chithigun23/ANUFS-GearPositionSTM/gearPosSens.kicad_pcb

## KiCad design gearPosSens.kicad_pcb (2026-11-10)

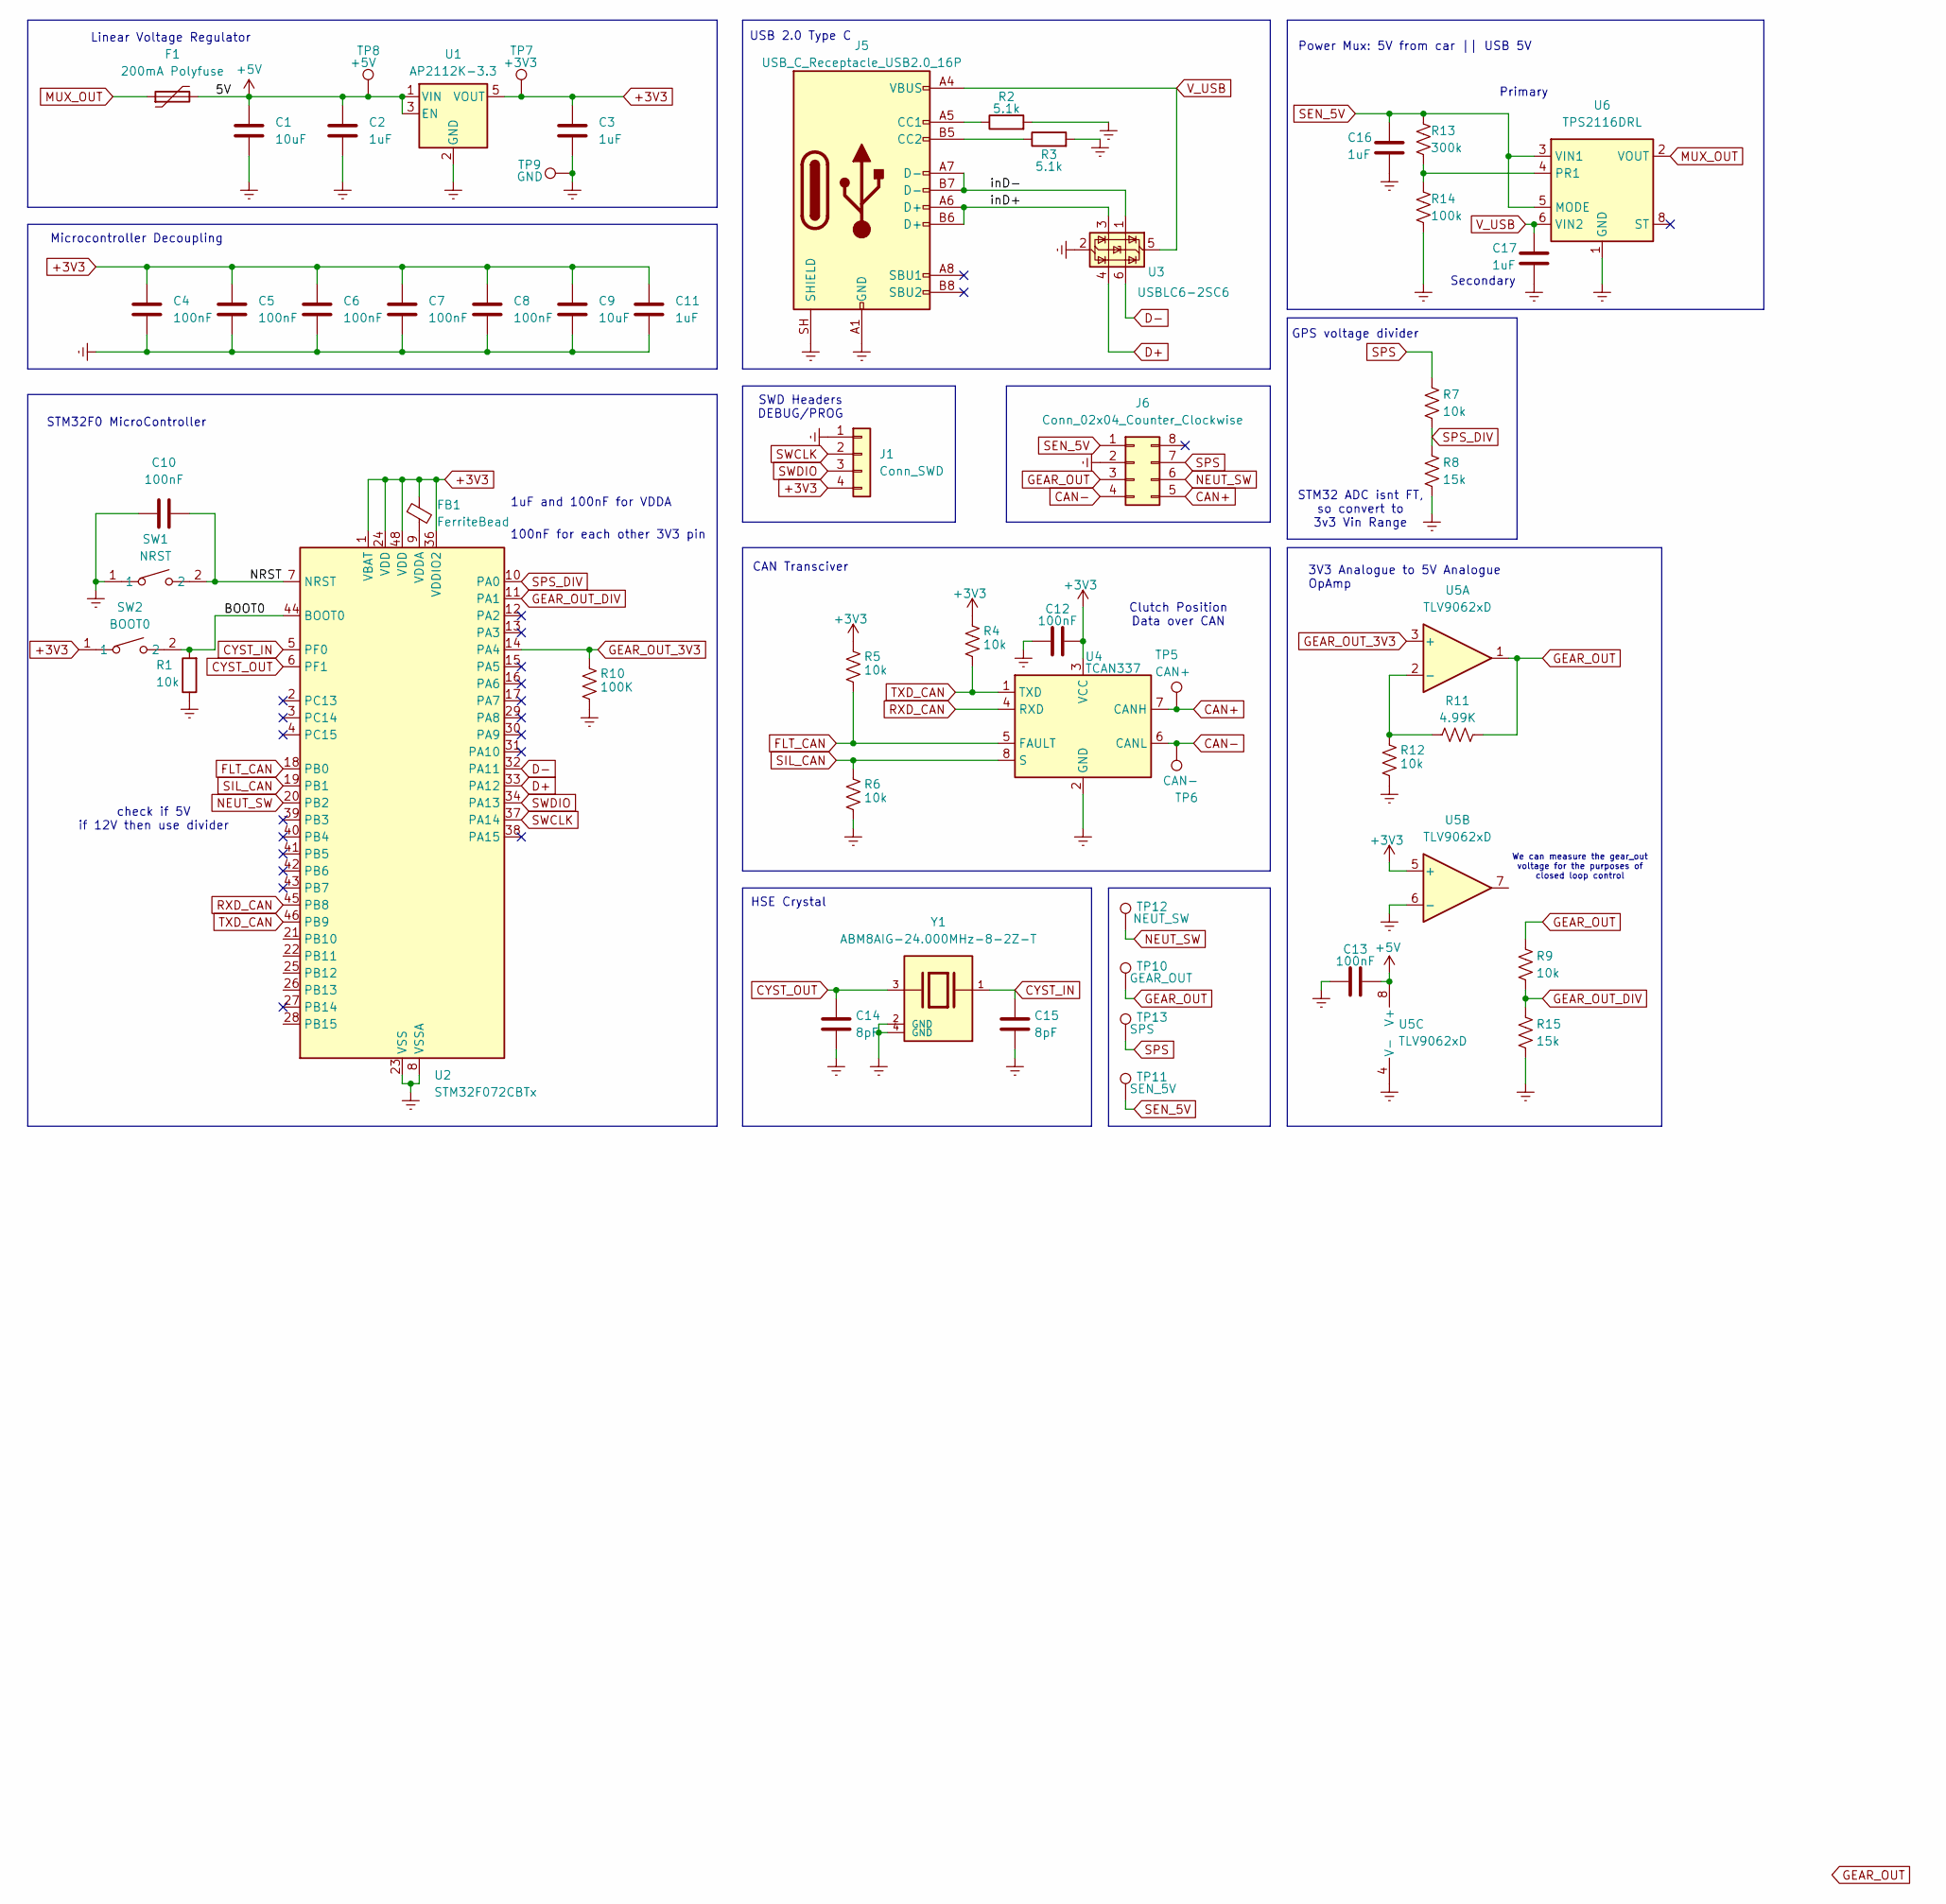
[picture p1: schematic gearPosSens.kicad_sch]

Parts:
C1, C9: 10uF; R_0805_2012Metric_Pad1.20x1.40mm_HandSolder
C2, C3, C11, C16, C17: 1uF; R_0805_2012Metric_Pad1.20x1.40mm_HandSolder
C4, C5, C6, C7, C8, C10, C12, C13: 100nF; R_0805_2012Metric_Pad1.20x1.40mm_HandSolder
C14, C15: 8pF; C_0402_1005Metric_Pad0.74x0.62mm_HandSolder
F1: 200mA Polyfuse; C_0603_1608Metric_Pad1.08x0.95mm_HandSolder
FB1: FerriteBead; C_0603_1608Metric_Pad1.08x0.95mm_HandSolder
J1: Conn_SWD; PinHeader_1x04_P2.54mm_Vertical
J5: USB_C_Receptacle_USB2.0_16P; USB-C-SMD_TYPE-C-16PIN-2MD-073
J6: Conn_02x04_Counter_Clockwise
R1, R4, R5, R6, R7, R9, R12: 10k; R_0805_2012Metric_Pad1.20x1.40mm_HandSolder
R2, R3: 5.1k; R_0805_2012Metric_Pad1.20x1.40mm_HandSolder
R8, R15: 15k; R_0805_2012Metric_Pad1.20x1.40mm_HandSolder
R10: 100K; R_0805_2012Metric_Pad1.20x1.40mm_HandSolder
R11: 4.99K
R13: 300k; R_0805_2012Metric_Pad1.20x1.40mm_HandSolder
R14: 100k; R_0805_2012Metric_Pad1.20x1.40mm_HandSolder
SW1: NRST; SW-SMD_L3.9-W3.0-P4.45; MPN TS-1088-AR02016; LCSC Part C720477
SW2: BOOT0; SW-SMD_L3.9-W3.0-P4.45; MPN TS-1088-AR02016; LCSC Part C720477
TP5: CAN+; TestPoint_THTPad_D2.0mm_Drill1.0mm
TP6: CAN-; TestPoint_THTPad_D2.0mm_Drill1.0mm
TP7: +3V3; TestPoint_THTPad_D2.0mm_Drill1.0mm
TP8: +5V; TestPoint_THTPad_D2.0mm_Drill1.0mm
TP9: GND; TestPoint_THTPad_D2.0mm_Drill1.0mm
TP10: GEAR_OUT; TestPoint_THTPad_D2.0mm_Drill1.0mm
TP11: SEN_5V; TestPoint_THTPad_D2.0mm_Drill1.0mm
TP12: NEUT_SW; TestPoint_THTPad_D2.0mm_Drill1.0mm
TP13: SPS; TestPoint_THTPad_D2.0mm_Drill1.0mm
U1: AP2112K-3.3; SOT-23-5_HandSoldering
U2: STM32F072CBTx; LQFP-48_7x7mm_P0.5mm
U3: USBLC6-2SC6; SOT-23-6
U4: TCAN337; SOIC-8_3.9x4.9mm_P1.27mm
U5: TLV9062xD; SOIC-8_3.9x4.9mm_P1.27mm
U6: TPS2116DRL; SOT-583-8
Y1: ABM8AIG-24.000MHz-8-2Z-T; ABM8AIG-24.000MHZ-8-2Z-T; PARTREV 43629

Connections:
+3V3: C3.1, C4.2, C5.2, C6.2, C7.2, C8.2, C9.2, C11.1, C12.2, FB1.1, J1.4, R4.1, R5.1, SW2.1, TP7.1 (1_1), U1.5 (VOUT), U2.1 (VBAT), U2.24 (VDD), U2.36 (VDDIO2), U2.48 (VDD), U4.3 (VCC), U5.5 (+); also elsewhere on the board
/BOOT0: R1.2, SW2.2, U2.44 (BOOT0)
/NRST: C10.2, SW1.2, U2.7 (NRST)
/inD+: J5.A6 (D+), J5.B6 (D+), U3.3 (I/O2)
/inD-: J5.A7 (D-), J5.B7 (D-), U3.1 (I/O1)
CAN+: J6.5, TP5.1 (1_1), U4.7 (CANH); also elsewhere on the board
CAN-: J6.4, TP6.1 (1_1), U4.6 (CANL); also elsewhere on the board
CYST_IN: C15.1, U2.5 (PF0), Y1.1
CYST_OUT: C14.1, U2.6 (PF1), Y1.3
D+: U2.33 (PA12), U3.4 (I/O2)
D-: U2.32 (PA11), U3.6 (I/O1)
FLT_CAN: R5.2, U2.18 (PB0), U4.5 (FAULT)
GEAR_OUT: J6.3, R9.1, R11.2, TP10.1 (1_1), U5.1
GEAR_OUT_3V3: R10.1, U2.14 (PA4), U5.3 (+)
GEAR_OUT_DIV: R9.2, R15.1, U2.11 (PA1)
GND: C1.1, C2.2, C3.2, C4.1, C5.1, C6.1, C7.1, C8.1, C9.1, C10.1, C11.2, C12.1, C13.1, C14.2, C15.2, C16.1, C17.1, J1.1, J5.A1 (GND), J5.A12 (GND), J5.B1 (GND), J5.B12 (GND), J5.SH (SHIELD), J6.2, R1.1, R2.2, R3.2, R6.2, R8.2, R10.2, R12.2, R14.2, R15.2, SW1.1, TP9.1 (1_1), U1.2 (GND), U2.8 (VSSA), U2.23 (VSS), U2.35 (VSS), U2.47 (VSS), U3.2 (GND), U4.2 (GND), U5.4 (V-), U5.6 (-), U6.1 (GND), Y1.2 (GND), Y1.4 (GND)
NEUT_SW: J6.6, TP12.1 (1_1), U2.20 (PB2)
unnamed: J5.A5 (CC1), R2.1
unnamed: J5.B5 (CC2), R3.1
unnamed: FB1.2, U2.9 (VDDA)
unnamed: R11.1, R12.1, U5.2 (-)
unnamed: R13.2, R14.1, U6.4 (PR1)
RXD_CAN: U2.45 (PB8), U4.4 (RXD)
SEN_5V: C16.2, J6.1, R13.1, TP11.1 (1_1), U6.3 (VIN1), U6.5 (MODE)
SIL_CAN: R6.1, U2.19 (PB1), U4.8 (S)
SPS: J6.7, R7.1, TP13.1 (1_1)
SPS_DIV: R7.2, R8.1, U2.10 (PA0)
SWCLK: J1.2, U2.37 (PA14)
SWDIO: J1.3, U2.34 (PA13)
TXD_CAN: R4.2, U2.46 (PB9), U4.1 (TXD)
V_USB: C17.2, J5.A4 (VBUS), J5.A9 (VBUS), J5.B4 (VBUS), J5.B9 (VBUS), U3.5 (VBUS), U6.6 (VIN2)

Notes on the sheet:
We can measure the gear_out voltage for the purposes of closed loop control
GPS voltage divider
100nF for each other 3V3 pin
Microcontroller Decoupling
3V3 Analogue to 5V Analogue OpAmp
CAN Transciver
Secondary
SWD Headers DEBUG/PROG
Power Mux: 5V from car || USB 5V
HSE Crystal
1uF and 100nF for VDDA
Clutch Position Data over CAN
USB 2.0 Type C
Linear Voltage Regulator
check if 5V if 12V then use divider
Primary
STM32F0 MicroController
STM32 ADC isnt FT, so convert to 3v3 Vin Range

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
Board: 4 copper layers, 56 parts (0 on the bottom side), 33 nets, no tracks yet.

Other parts of the board:
TP14: +3V3; TestPoint_THTPad_D2.0mm_Drill1.0mm
TP15: CAN+; TestPoint_THTPad_D2.0mm_Drill1.0mm
TP16: CAN-; TestPoint_THTPad_D2.0mm_Drill1.0mm

Their connections:
+3V3: TP14.1 (1_1); also elsewhere on the board
CAN+: TP15.1 (1_1); also elsewhere on the board
CAN-: TP16.1 (1_1); also elsewhere on the board
