chithigun23/ANUFS-GearPositionSTM/(commit log)

2026-09-03 Added DAC
    [gearPosSens.kicad_pcb, gearPosSens.kicad_sch]
2026-09-03 Finished circuit design draft
    [gearPosSens.kicad_pcb, gearPosSens.kicad_sch]
2026-09-03 change in file structure
    [gearPosSens.kicad_pcb, gearPosSens.kicad_sch]
2026-09-03 Added more test points
    [gearPosSens.kicad_sch]
2026-09-08 Checkpoint before power-mux schematic placement
    Adds the gear library parts for the car-12V/USB-5V power mux
    (SMBJ33A, PMEG6010ER, LMR33630ADDAR, TPS2113APWR) plus session notes,
    captured as a clean baseline before the mux is wired into the schematic
    so that change can be reverted independently if needed.
    [gearPosSens.kicad_pcb]
2026-09-08 Add car-12V/USB-5V power mux to the schematic
    Adds a self-contained block (own bounding rectangle, upper right, on a
    newly-widened A3 sheet) implementing the mux discussed: WAGO 12V input
    (J6) -> SMBJ33A TVS + 500mA polyfuse (F2) + PMEG6010ER reverse-polarity
    diode (D1) -> LMR33630ADDAR buck to 5V (U6) -> TPS2113APWR ideal-diode
    mux (U7, autoswitching: VSNS/EN/GND grounded) -> VIN_LDO.
    The only edit to existing content: the single wire segment directly
    between F1 and the rest of the VIN_LDO run is cut, F1's pin is relabeled
    5V_USB (feeding the mux's IN2), and the untouched VIN_LDO label/run now
    picks up power from the mux's OUT pin instead of straight from F1 -- so
    U1 and everything else al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
    [gearPosSens.kicad_sch]
2026-09-11 Removed buck converter as 12V is not required
    [gearPosSens.kicad_pcb, gearPosSens.kicad_sch]
2026-09-11 Added crystal for HSE, required for CAN
    [gearPosSens.kicad_sch]
2026-09-11 Move HSE crystal into the gear library
    Y1 pointed at the apppd footprint and telemetry symbol libraries, neither of which this project declares, so the footprint could not be placed on the PCB. The ABM8AIG-24.000MHz-8-2Z-T symbol, footprint and 3D model now live in library/ and Y1 uses the gear nickname. The symbol library table also had an empty type, which stopped KiCad loading the gear library at all; it is now KiCad. Netlist unchanged: 64 nets, 54 components, no pin moved.
    [gearPosSens.kicad_sch]
2026-09-11 Small fixes
    [gearPosSens.kicad_pcb, gearPosSens.kicad_sch]
2026-11-10 Replace the MCP4801 with the STM32 DAC and a TLV9062 op-amp stage with ADC readback, and add 1 uF caps on the power mux inputs.
    Remove the reverse-polarity stage and unused library parts, and rewrite the README, architecture diagram and power notes to match.
    [gearPosSens.kicad_pcb, gearPosSens.kicad_sch]
2026-11-11 DAC replaced with opamp from internal DAC translating 0-3v3 to 0-5v and using closed loop control of the output
    [gearPosSens.kicad_sch]
